KimiakiK/RPiWD/README.md

# R RPiWD - 小型対面対戦ゲーム機 -

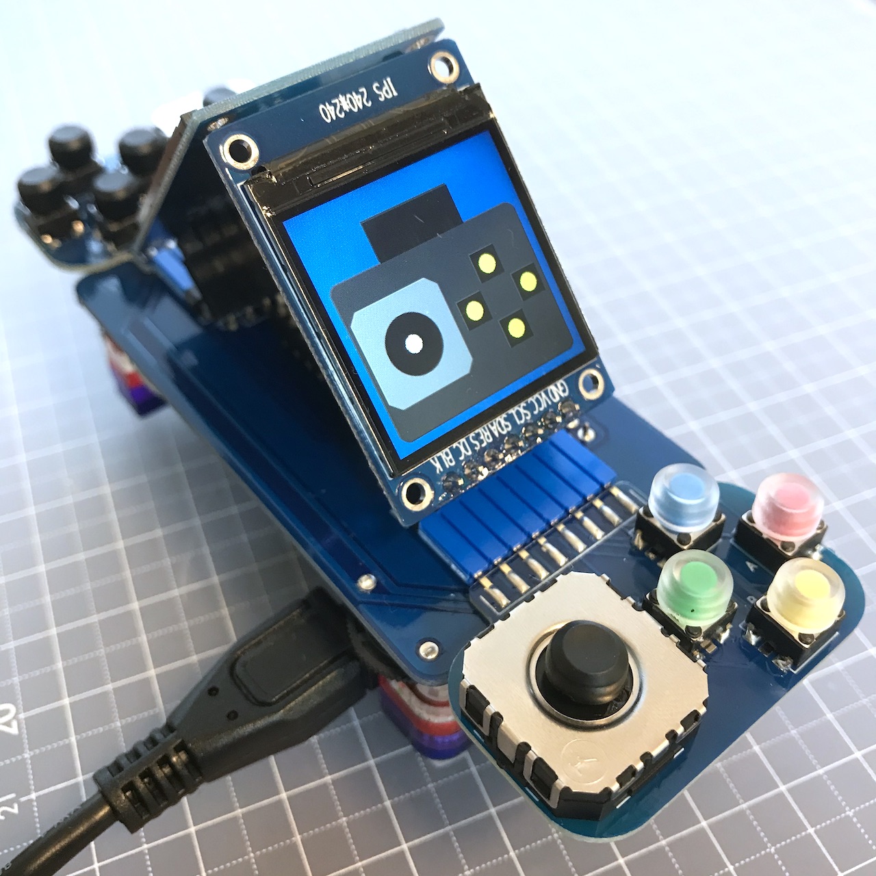
[picture p1: Document/Photo/PCB/RPiWD_Left.jpg]


RPiWD(ラズパイダブルディスプレイ)はRaspberry Pi Zeroに取り付けてゲームが遊べる HATです。
