KimiakiK/RPiWD/Document/Photo/PCB/RPiWD_Original.jpg

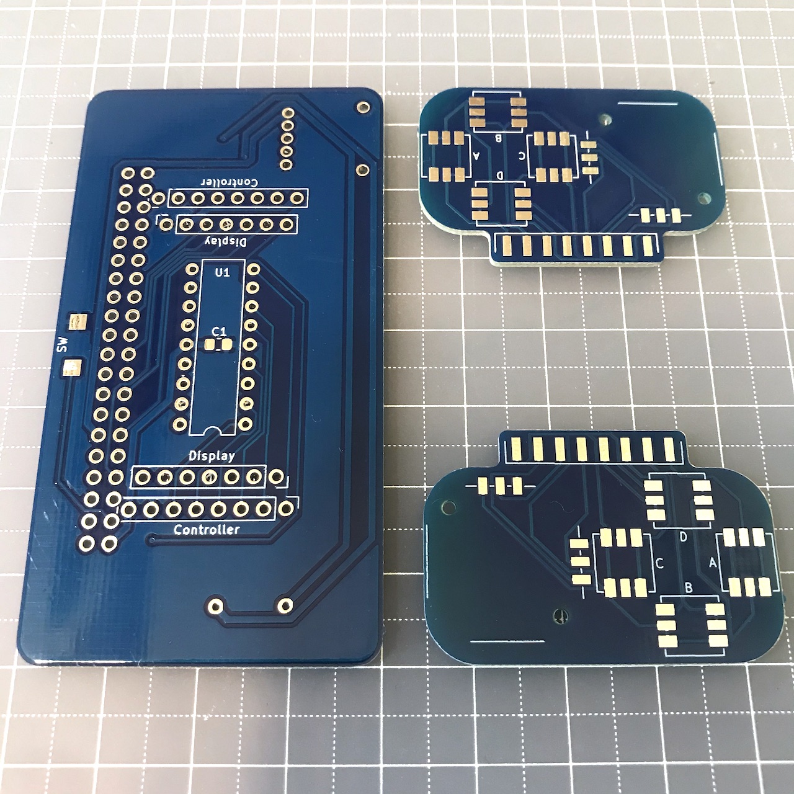
Document/Photo/PCB/RPiWD_Original.jpg
