KimiakiK/RPiWD/Document/Photo/PCB/RPiWD_Right.jpg

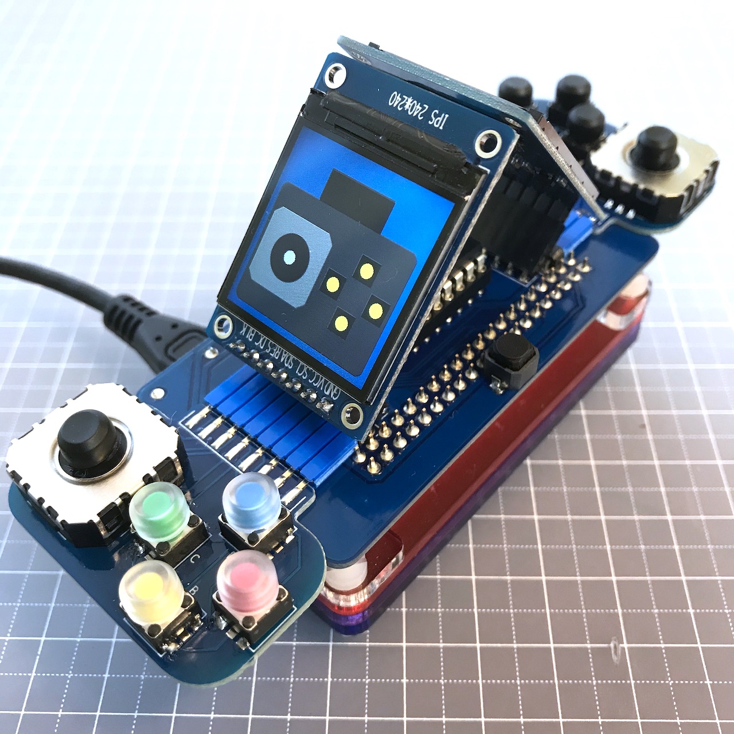
Document/Photo/PCB/RPiWD_Right.jpg
