KimiakiK/RPiWD/Document/Photo/UniversalBoard/RPiWD_lookdown.jpg

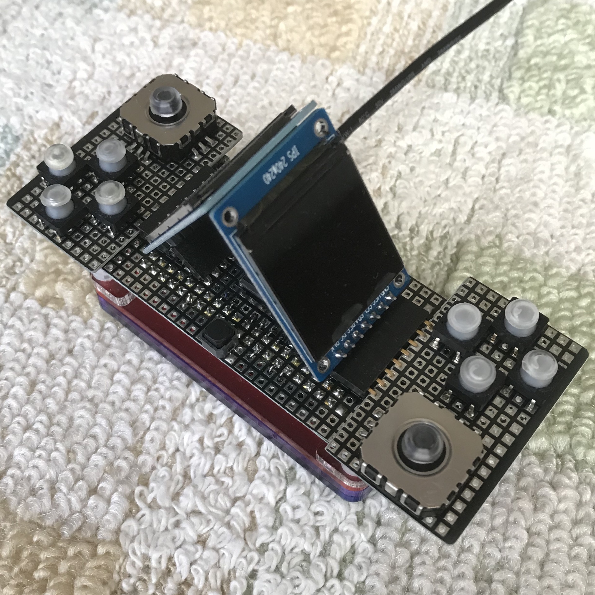
Document/Photo/UniversalBoard/RPiWD_lookdown.jpg
