KimiakiK/RPiWD/Document/Photo/UniversalBoard/RPiWD_Opening.jpg

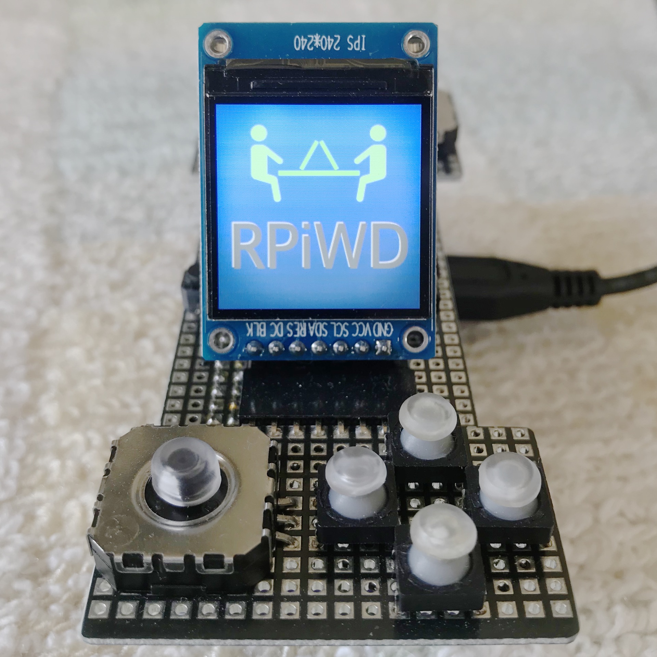
Document/Photo/UniversalBoard/RPiWD_Opening.jpg
