KimiakiK/RPiWD/Document/Photo/UniversalBoard/RPiWD_overview.jpg

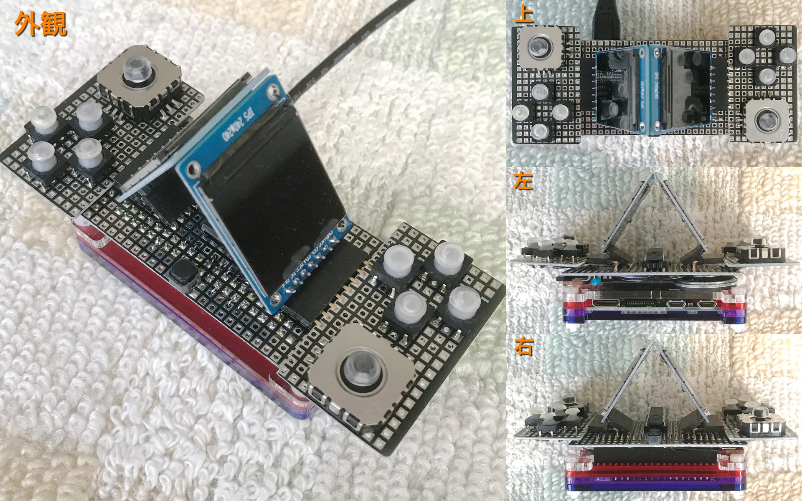
Document/Photo/UniversalBoard/RPiWD_overview.jpg
