KimiakiK/RPiWD/Document/Photo/UniversalBoard/RPiWD_protoboard.jpg

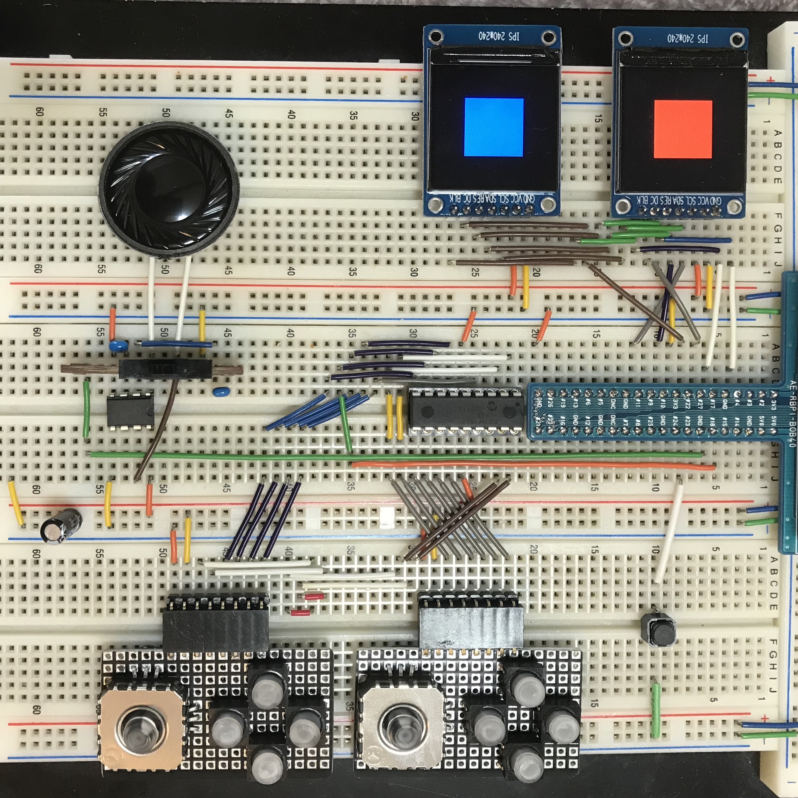
Document/Photo/UniversalBoard/RPiWD_protoboard.jpg
