KimiakiK/RPiWD/Document/Photo/UniversalBoard/RPiWD_side1.jpg

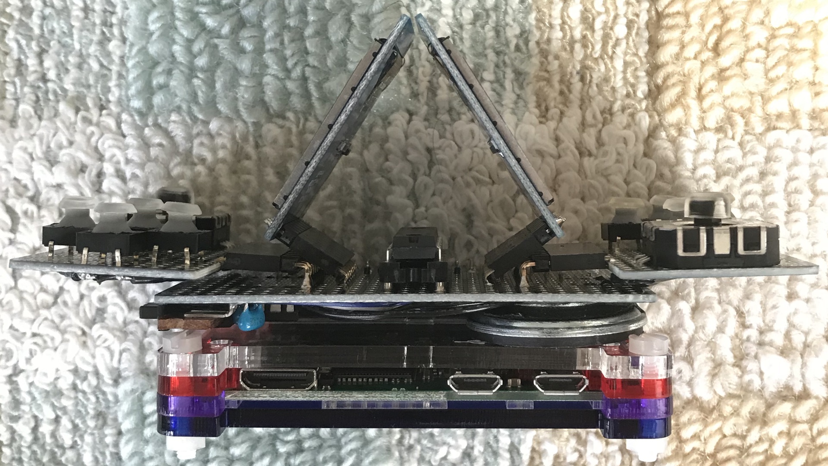
Document/Photo/UniversalBoard/RPiWD_side1.jpg
