KimiakiK/RPiWD/Document/Photo/UniversalBoard/RPiWD_side2.jpg

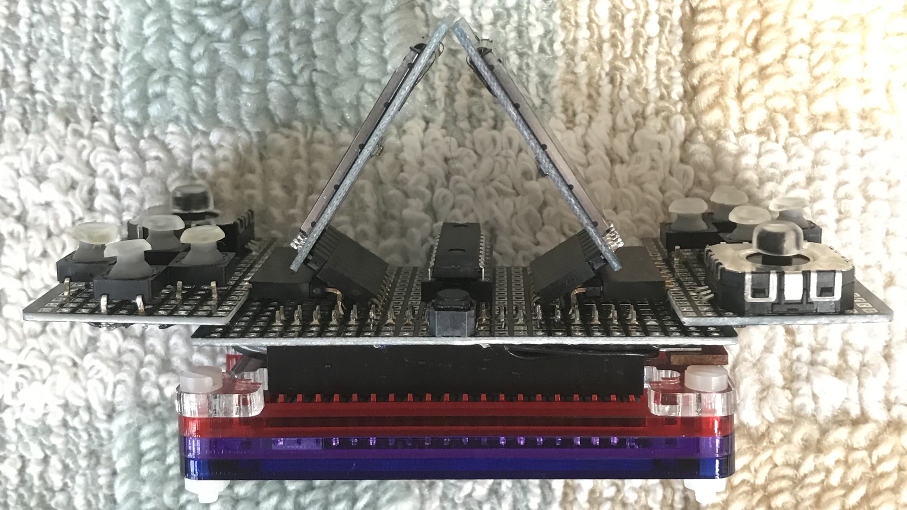
Document/Photo/UniversalBoard/RPiWD_side2.jpg
