KimiakiK/RPiWD/Document/Photo/UniversalBoard/RPiWD_up.jpg

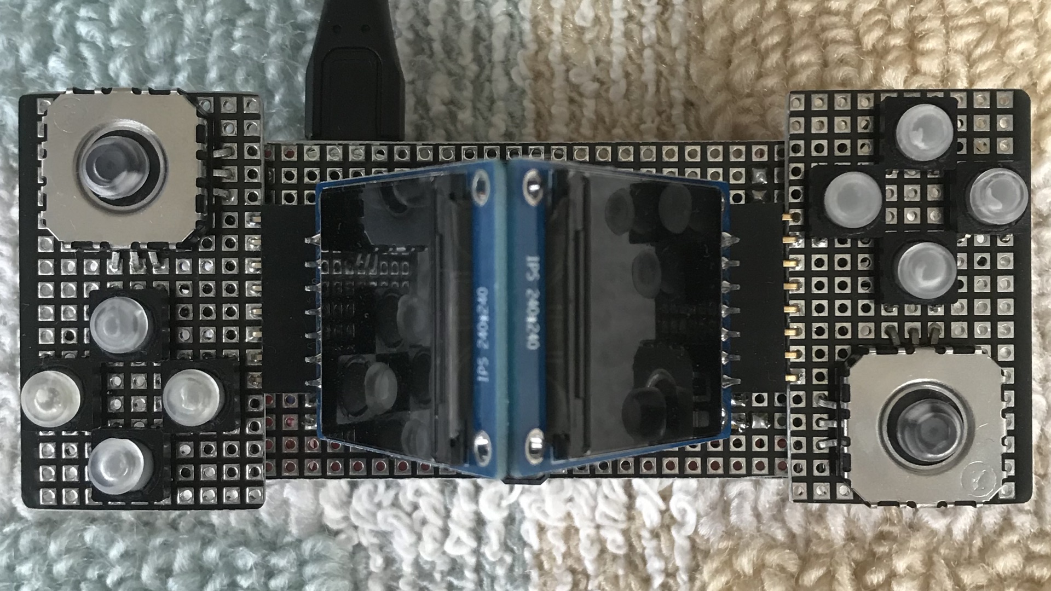
Document/Photo/UniversalBoard/RPiWD_up.jpg
