KimiakiK/RPiWD/Document/Photo/PCB/RPiWD_Parts.jpg

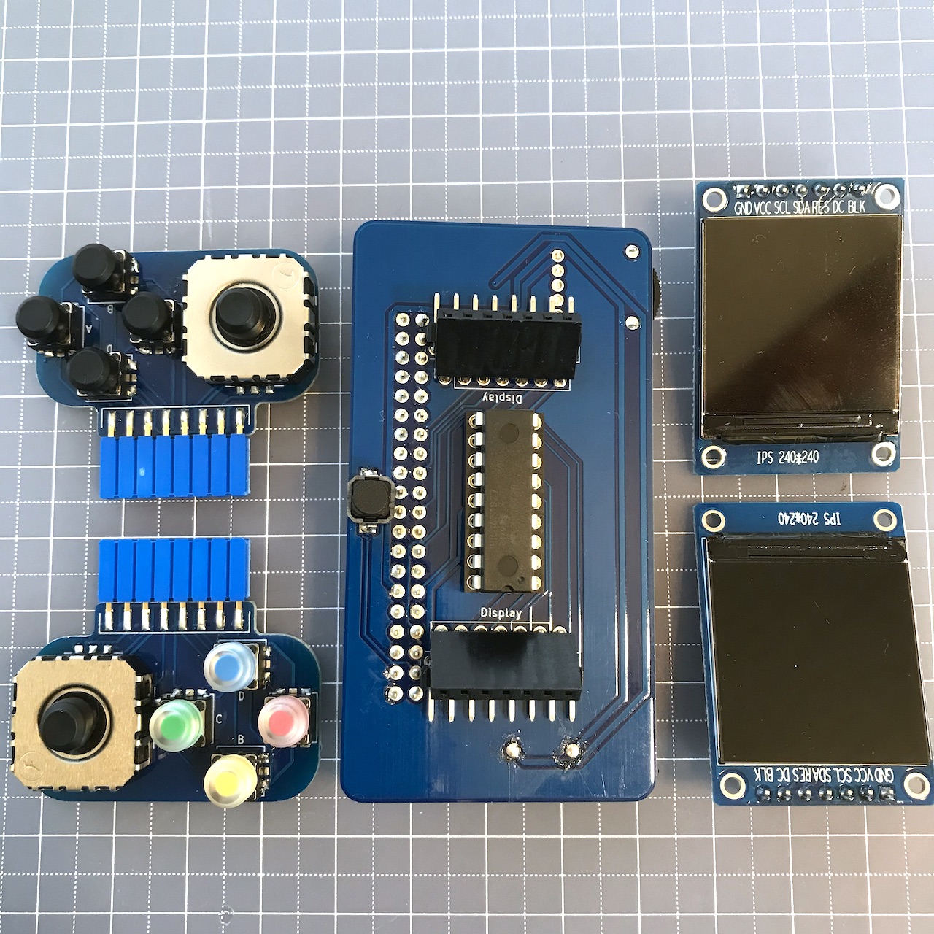
Document/Photo/PCB/RPiWD_Parts.jpg
