KimiakiK/RPiWD/Document/Photo/UniversalBoard/RPiWD_Parts.jpg

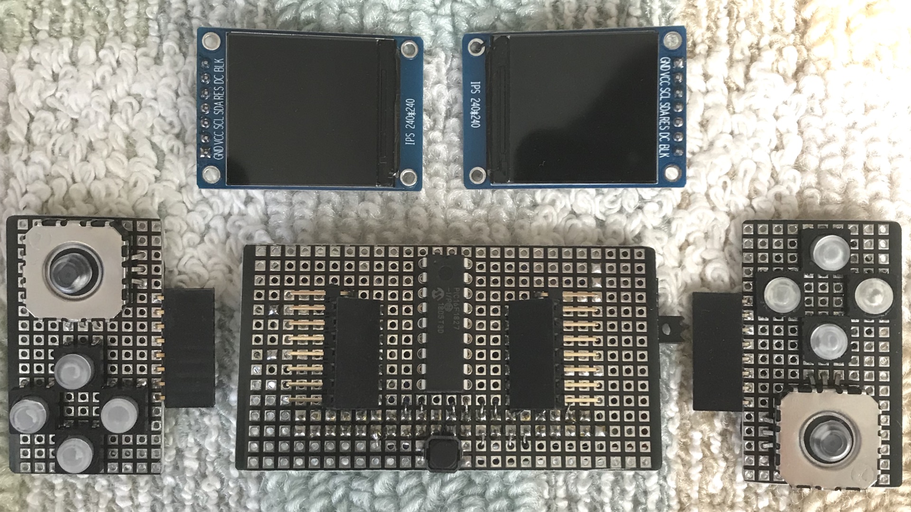
Document/Photo/UniversalBoard/RPiWD_Parts.jpg
