KimiakiK/RPiWD/Document/Photo/UniversalBoard/RPiWD_Parts_reverse.jpg

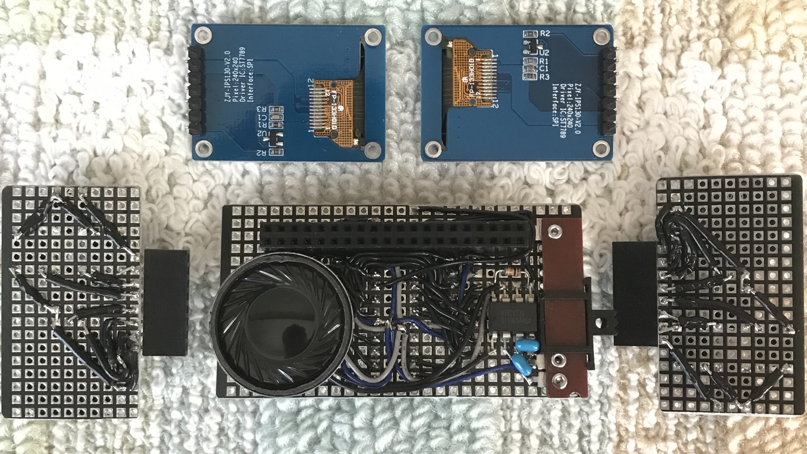
Document/Photo/UniversalBoard/RPiWD_Parts_reverse.jpg
