KimiakiK/RPiWD/Document/Design/RPiWD_Controller_DFD.pdf

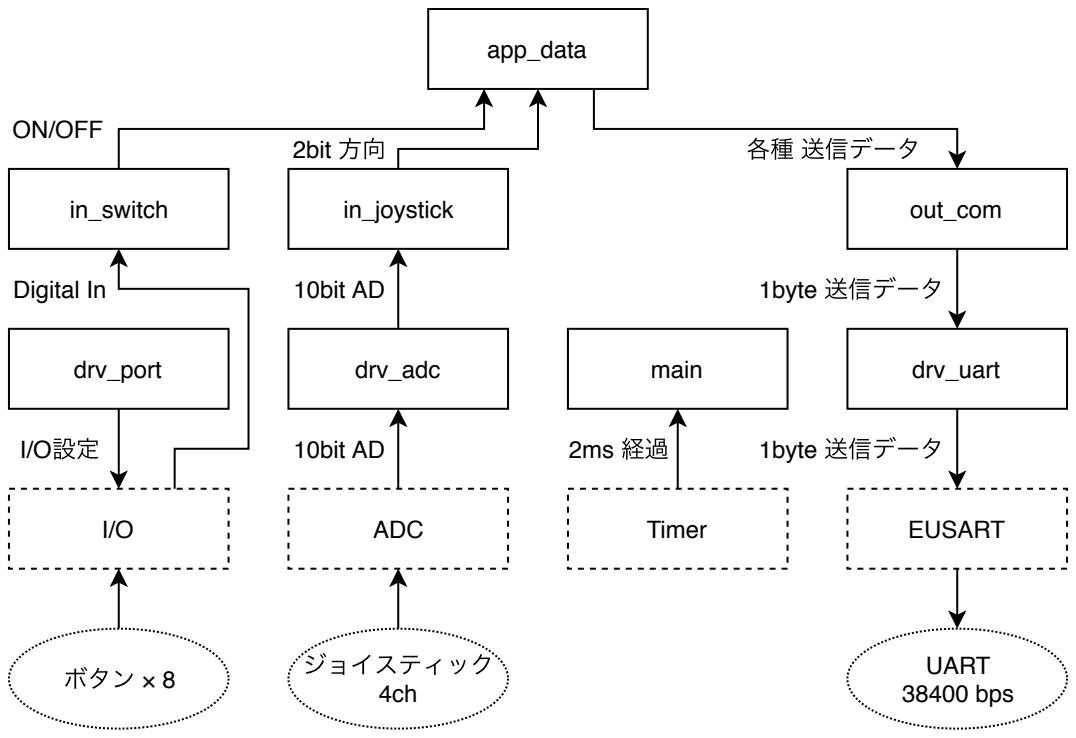
[picture p14: page 1]
ADC; Timer; EUSART; drv_port; drv_adc; main; drv_uart; in_switch; in_joystick; out_com; app_data; ボタン × 8; ジョイスティック; UART 38400 bps; I/O設定; Digital In; 10bit AD; 2bit ⽅向; ON/OFF; 各種 送信データ; 1byte 送信データ
