KimiakiK/RPiWD/Document/Design/RPiWD_BlockDiagram.pdf

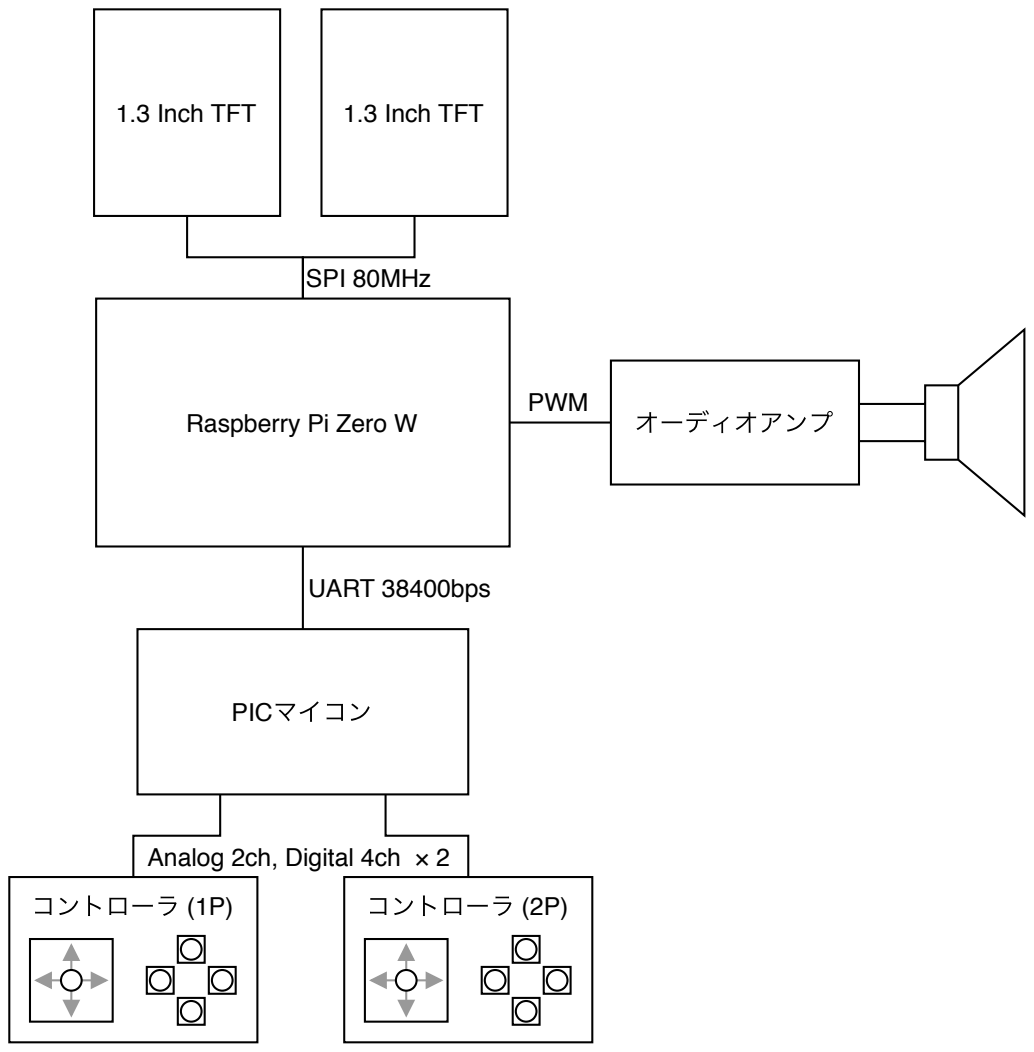
[picture p15: page 1]
1.3 Inch TFT; オーディオアンプ; PICマイコン; コントローラ (1P); コントローラ (2P); SPI 80MHz; PWM; UART 38400bps; Analog 2ch, Digital 4ch × 2

Raspberry Pi Zero W
