KimiakiK/RPiWD/Document/Design/RPiWD_Platform_DFD.pdf

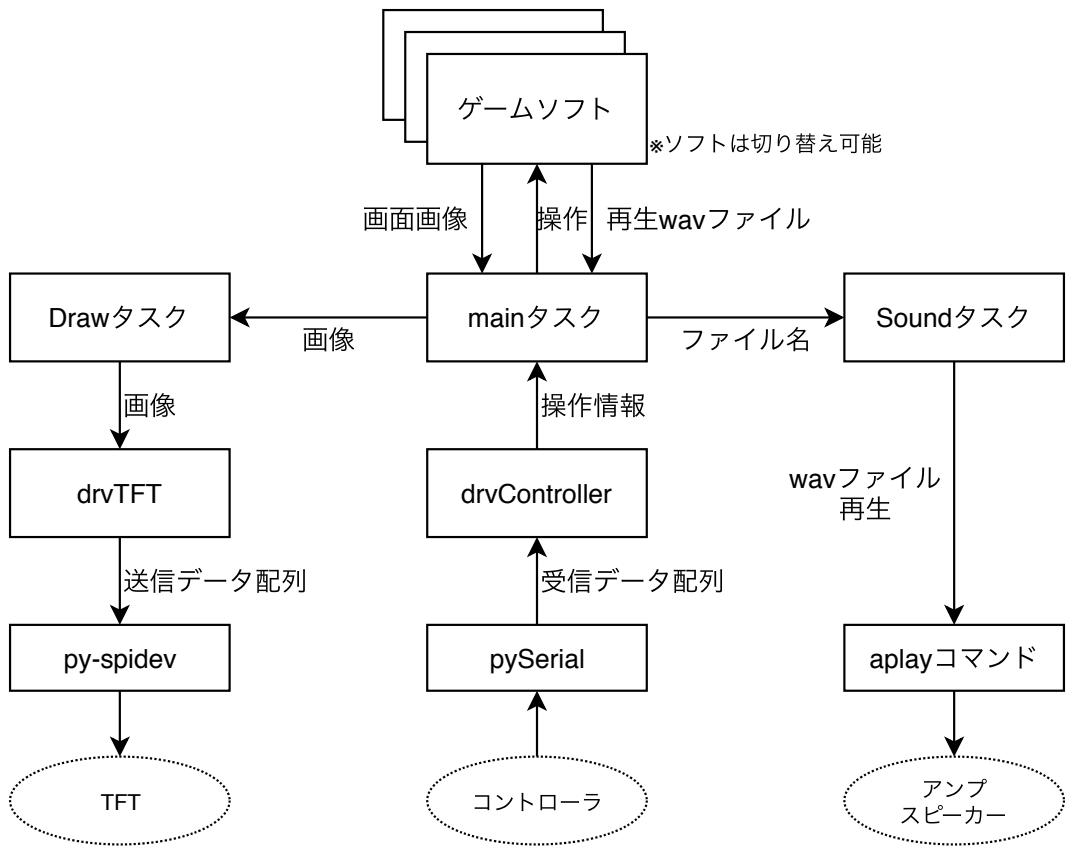
[picture p17: page 1]
Drawタスク; mainタスク; Soundタスク; drvTFT; drvController; py-spidev; pySerial; aplayコマンド; ゲームソフト; 送信データ配列; ファイル名; wavファイル 再⽣; 受信データ配列; 操作情報; 再⽣wavファイル; ※ソフトは切り替え可能; TFT; コントローラ; アンプ スピーカー
