KimiakiK/RPiWD/Document/CAD/RPiWD_Controller/RPiWD_Controller.pdf

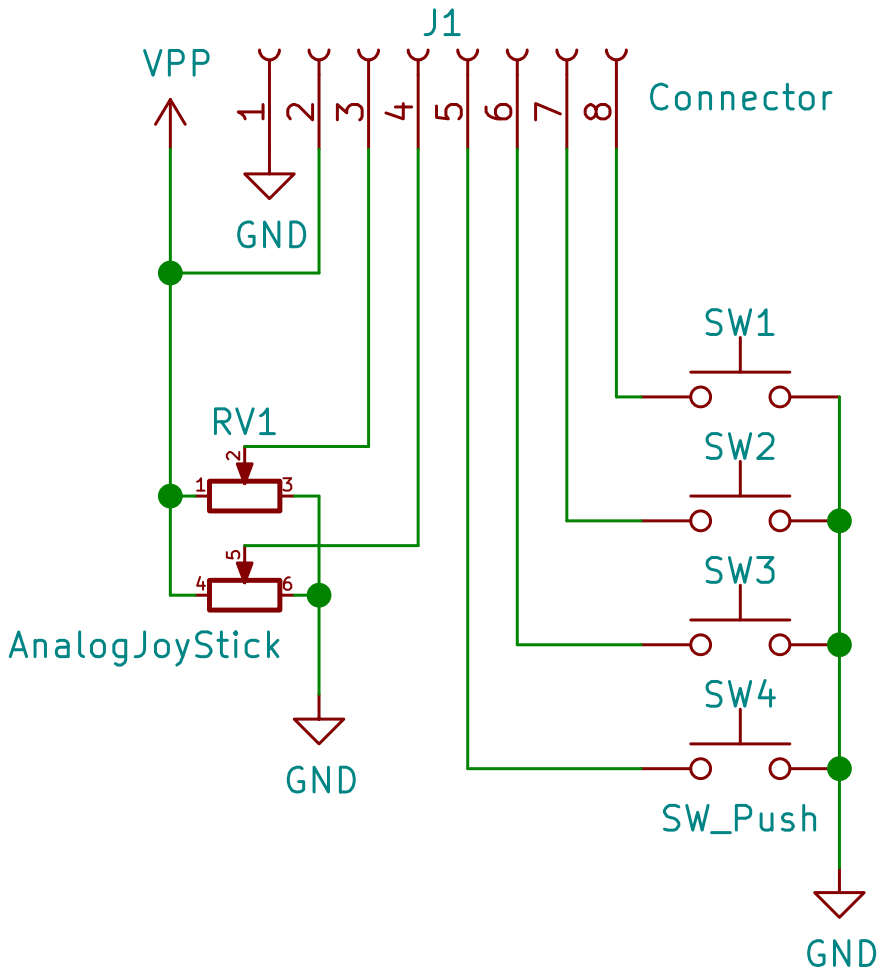
[picture p18: page 1]
