KimiakiK/RPiWD/(list of files, drawings)

Other design files:
Document/CAD/RPiWD_Main/RPiWD_Main.dsn
