KimiakiK/RPiWD/Document/CAD/RPiWD_Main/RPiWD_Main.kicad_pcb

## KiCad design Document/CAD/RPiWD_Main/RPiWD_Main.kicad_pcb (2020-01-11)

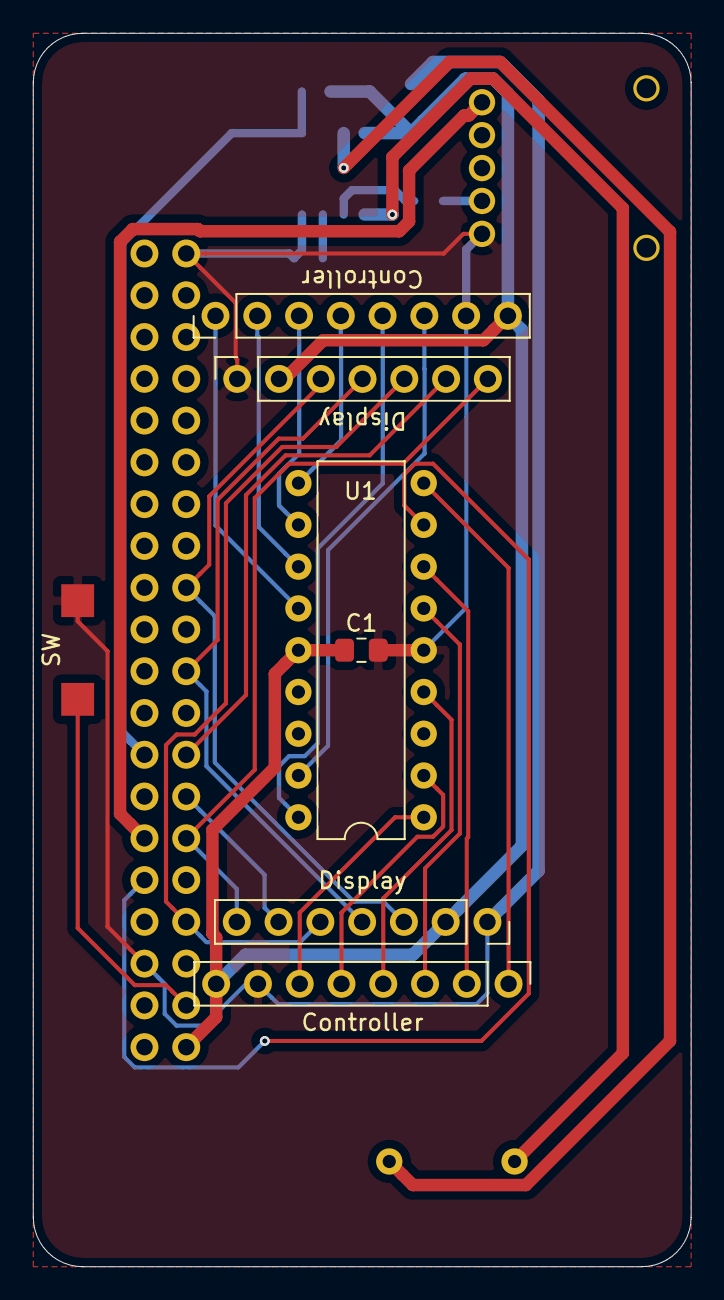
[picture p19: board RPiWD_Main.kicad_pcb from above]

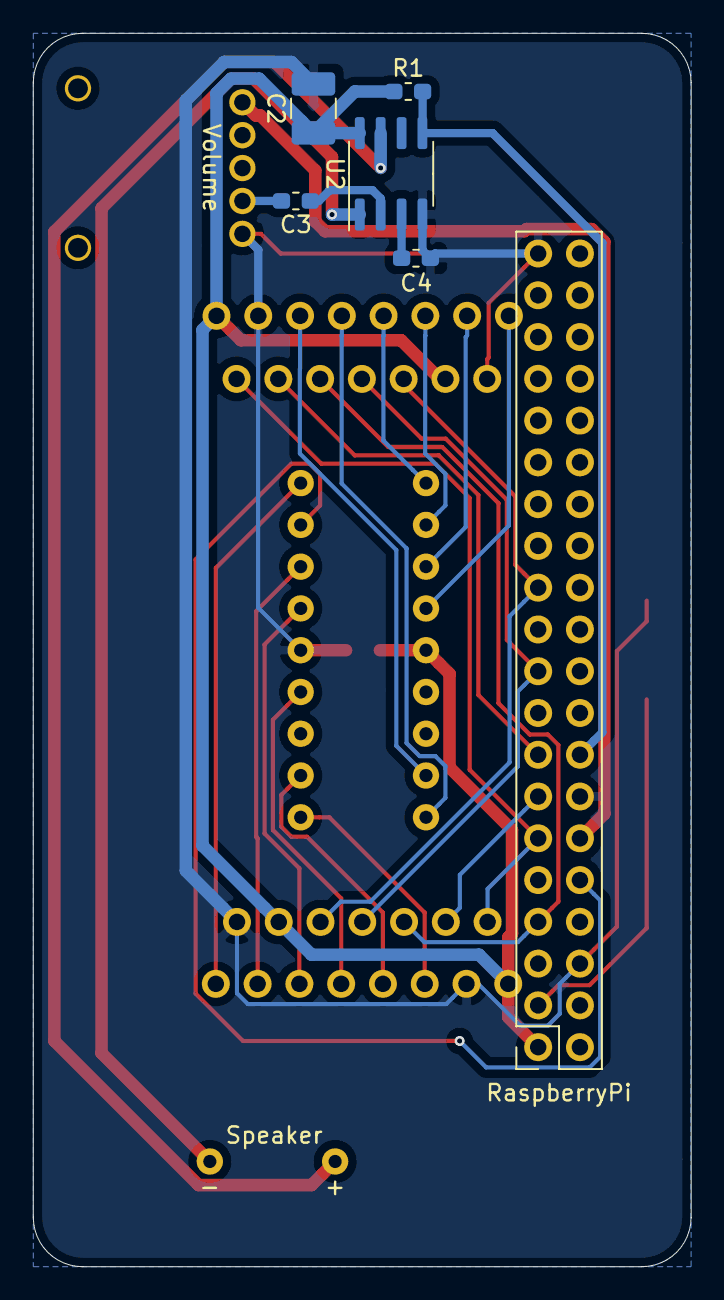
[picture p20: board RPiWD_Main.kicad_pcb from below]

Board: 2 copper layers, 40.0 x 75.0 mm, 15 parts (8 on the bottom side), 29 nets.

Parts:
C1: 0.1u; C_0805_2012Metric_Pad1.15x1.40mm_HandSolder
C2: 47u; C_1210_3225Metric_Pad1.42x2.65mm_HandSolder
C3, C4: 1u; C_0603_1608Metric_Pad1.05x0.95mm_HandSolder
Controller: Controller1; PinHeader_1x08_P2.54mm_Vertical
Controller#2: Controller2; PinHeader_1x08_P2.54mm_Vertical
Display: TFT; PinSocket_1x07_P2.54mm_Vertical
Display#2: TFT_1_3_inch; PinSocket_1x07_P2.54mm_Vertical
R1: 10k; R_0603_1608Metric_Pad1.05x0.95mm_HandSolder
RaspberryPi: Raspberry_Pi_Zero; PinSocket_2x20_P2.54mm_Vertical
SW: SW_Push; Switch_TS665SG-S
Speaker: Speaker; Speaker_SP-281W
U1: PIC16F1827; DIP-18_W7.62mm
U2: HT82V739; SOIC-8_3.9x4.9mm_P1.27mm
Volume: Vol; Volume_RK10J

Connections:
+3V3: C1.1, C2.1, Controller.8, Controller#2.8, Display.2, Display#2.2, R1.1, RaspberryPi.1, U1.14, U2.8
GND: C1.2, C2.2, C4.2, Controller.7, Controller#2.7, Display.1, Display#2.1, RaspberryPi.6, RaspberryPi.14, RaspberryPi.39, SW.1, U1.5, U2.4, Volume.1
unnamed: C3.1, U2.2
unnamed: C3.2, Volume.2
unnamed: C4.1, U2.3
unnamed: RaspberryPi.3, SW.2
unnamed: Display.5, Display#2.5, RaspberryPi.7
unnamed: RaspberryPi.10, U1.8
unnamed: Display.7, Display#2.7, RaspberryPi.11
unnamed: RaspberryPi.12, Volume.3
unnamed: Display.6, RaspberryPi.13
unnamed: Display#2.6, RaspberryPi.15
unnamed: R1.2, RaspberryPi.16, U2.5
unnamed: Display.4, Display#2.4, RaspberryPi.19
unnamed: Display.3, Display#2.3, RaspberryPi.23
unnamed: Controller.1, U1.9
unnamed: Controller.2, U1.7
unnamed: Controller.3, U1.6
unnamed: Controller.4, U1.4
unnamed: Controller.5, U1.2
unnamed: Controller.6, U1.1
unnamed: Controller#2.1, U1.13
unnamed: Controller#2.2, U1.12
unnamed: Controller#2.3, U1.11
unnamed: Controller#2.4, U1.10
unnamed: Controller#2.5, U1.18
unnamed: Controller#2.6, U1.17
unnamed: Speaker.1, U2.1
unnamed: Speaker.2, U2.7
