KimiakiK/RPiWD/Document/CAD/RPiWD_Controller/RPiWD_Controller.kicad_pcb

## KiCad design Document/CAD/RPiWD_Controller/RPiWD_Controller.kicad_pcb (2020-01-11)

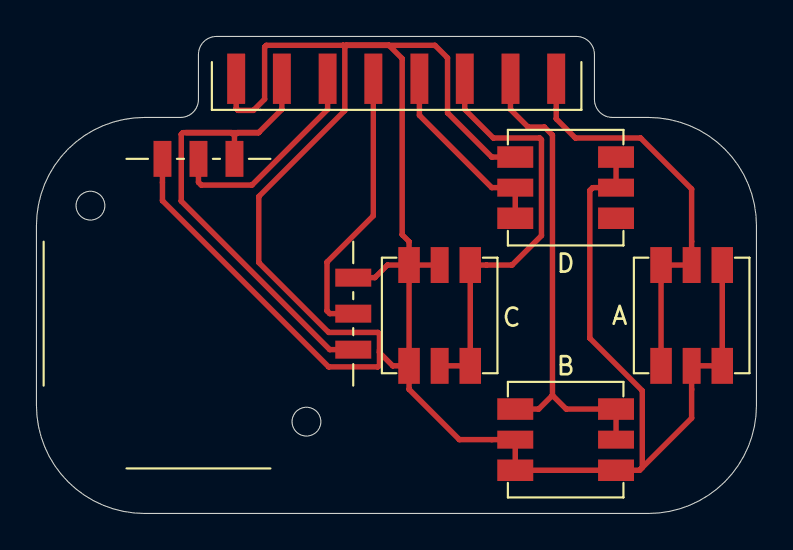
[picture p21: board RPiWD_Controller.kicad_pcb from above]

Board: 2 copper layers, 40.0 x 26.5 mm, 6 parts (0 on the bottom side), 8 nets.

Parts:
J1: Connector; Connecter_SMD_8pin
RV1: AnalogJoyStick
SW1: SW1; SW_SMD
SW2: SW2; SW_SMD
SW3: SW3; SW_SMD
SW4: SW4; SW_SMD

Connections:
GND: J1.1, RV1.3, RV1.6, SW1.2, SW2.2, SW3.2, SW4.2
unnamed: J1.3, RV1.2
unnamed: J1.4, RV1.5
unnamed: J1.5, SW4.1
unnamed: J1.6, SW3.1
unnamed: J1.7, SW2.1
unnamed: J1.8, SW1.1
VPP: J1.2, RV1.1, RV1.4
