KimiakiK/RPiWD/Controller.X/out_com.h

/* 
 * File:   out_com.h
 */

#ifndef OUT_COM_H
#define	OUT_COM_H


#define OUT_COM_DATA_LENGTH     4

extern void out_com_Init(void);
extern void out_com_Main(void);
extern void out_com_SetData(unsigned char* data);


#endif	/* OUT_COM_H */
