KimiakiK/RPiWD/(commit log)

2019-08-10 コントローラ動作確認用ソフト
2019-08-31 ブロック図、回路図、パーツリストを追加
2019-09-01 起動用スクリプト追加
2019-09-09 ソフトウェアDFD追加
2019-09-09 写真追加
2020-01-11 PCB版の写真追加
2020-01-11 CADデータ追加
    [RPiWDCntr.drl, RPiWDCntr.gm1, RPiWDCntr.gtl, RPiWDCntr.gto, RPiWDCntr.gtp, RPiWDCntr.gts, RPiWDMain.drl, RPiWDMain.gbl]
